edwardo1239/seleccionadora-platanos/python/prueba1_cargar_imagenes/fondo_REDUCIDO.jpg

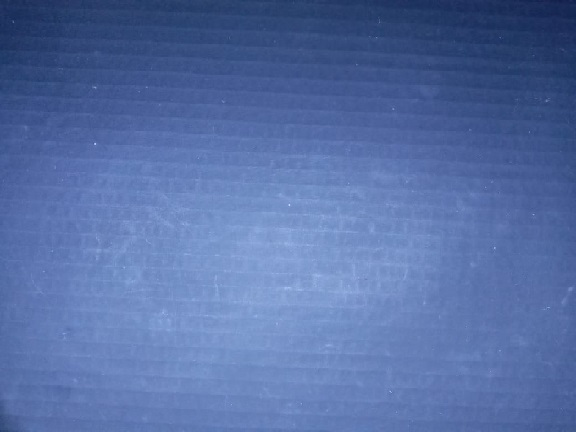
python/prueba1_cargar_imagenes/fondo_REDUCIDO.jpg
