edwardo1239/seleccionadora-platanos/python/prueba1_cargar_imagenes/platano_reducido_2.jpg

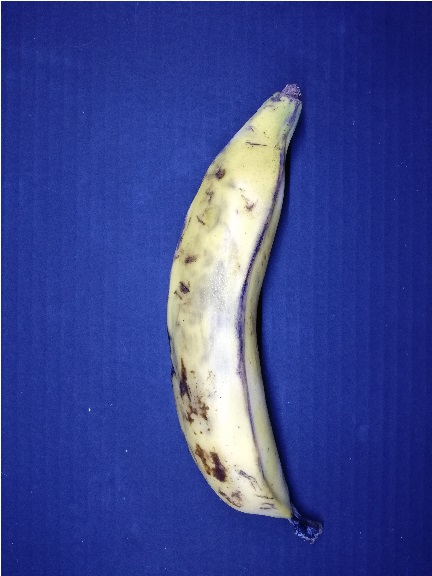
python/prueba1_cargar_imagenes/platano_reducido_2.jpg
