edwardo1239/seleccionadora-platanos/python/codigos_finales/170.jpg

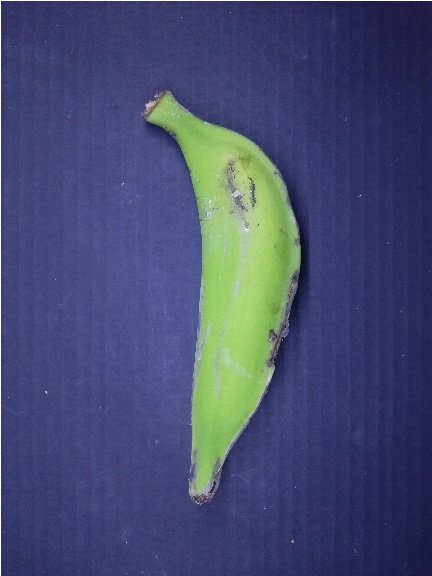
python/codigos_finales/170.jpg
