edwardo1239/seleccionadora-platanos/python/HSV/2.jpg

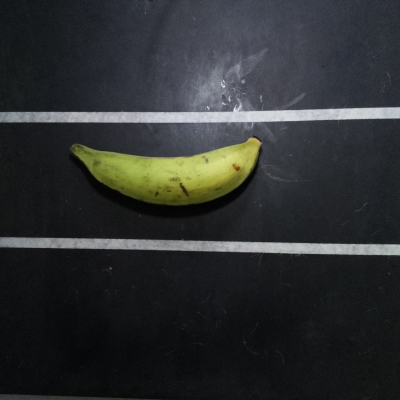
python/HSV/2.jpg
