edwardo1239/seleccionadora-platanos/python/HSV/fondo.jpg

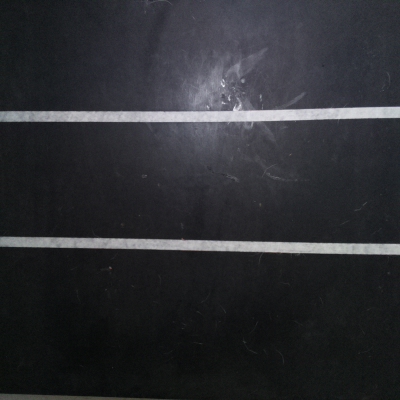
python/HSV/fondo.jpg
