edwardo1239/seleccionadora-platanos/python/segmentacion/foto_1.jpg

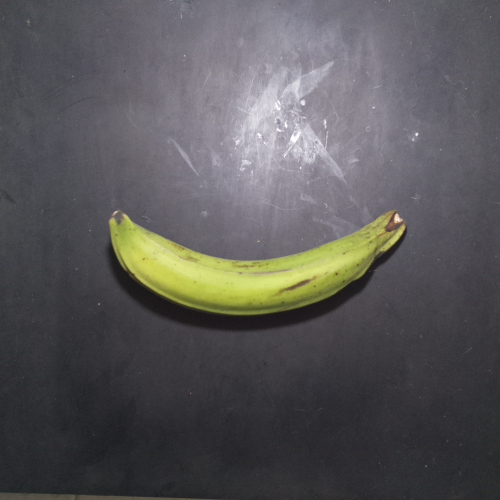
python/segmentacion/foto_1.jpg
