edwardo1239/seleccionadora-platanos/python/segmentacion/foto_fondo.jpg

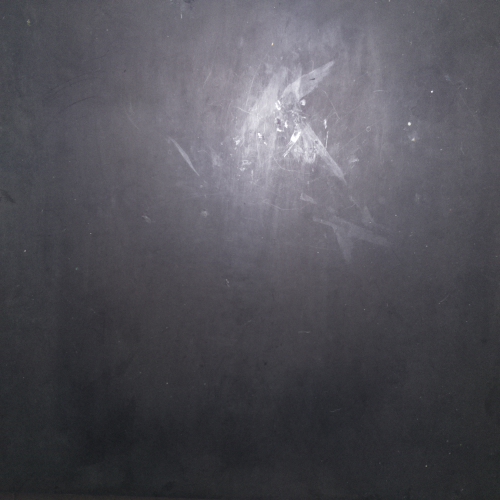
python/segmentacion/foto_fondo.jpg
