edwardo1239/seleccionadora-platanos/python/transformada_de_hough/ejedrez.jpg

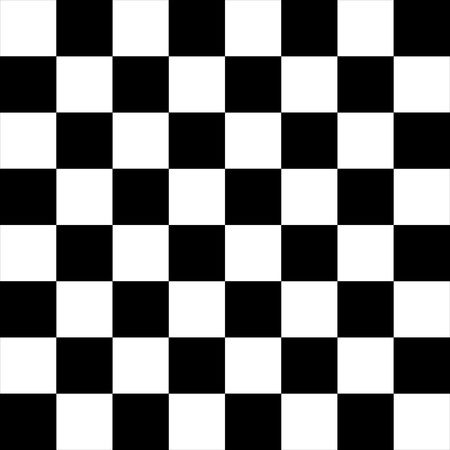
python/transformada_de_hough/ejedrez.jpg
