edwardo1239/seleccionadora-platanos/esquematico/esquema.pdf

U1

L1

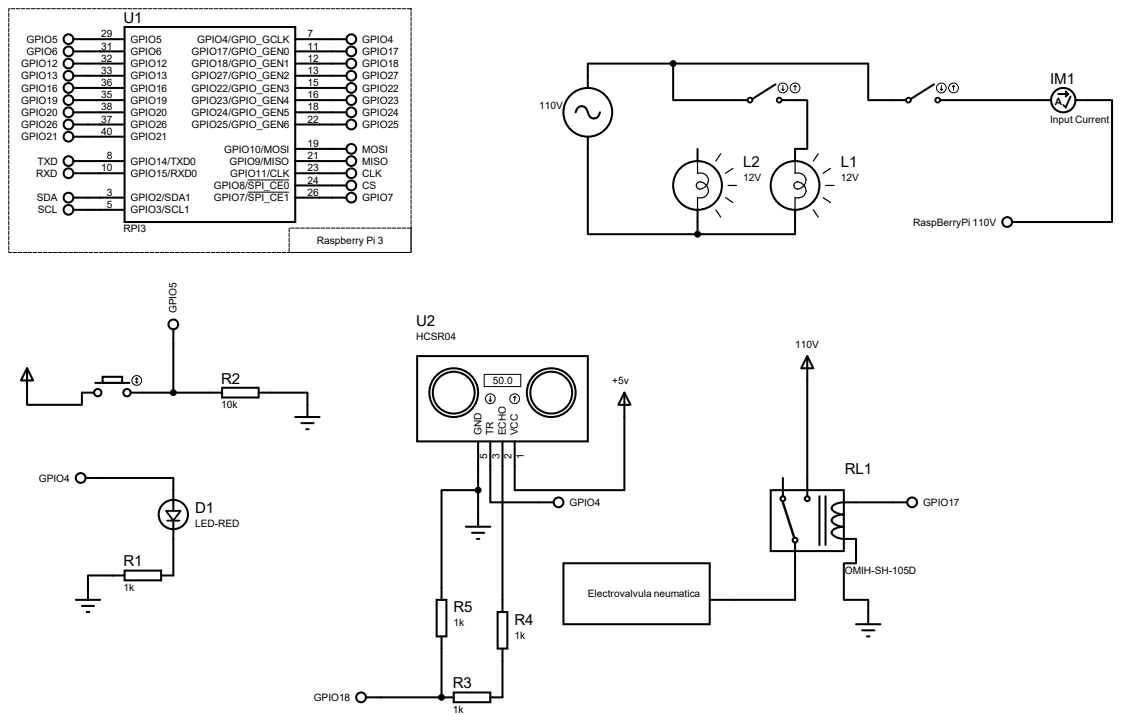
[picture p53: page 1]
