edwardo1239/seleccionadora-platanos/(list of files, drawings)

Other design files:
esquematico/boton_apagar.pdsprj
